Oh-Low/peeple-beeper/docs/first-boot-notes.md

# First boot notes

Work for the PCB stage. The breadboard keeps its current compass numbers and GPS schedule until then. Add the next item here when it comes up.

- [ ] Calibrate the magnetometer for the PCB.
- [ ] Calibrate true north, south, east, and west.
- [ ] Force a sky wait on first boot so the receiver can take its first satellite fix.
