Oh-Low/peeple-beeper/hardware/pcb/pcb.kicad_pcb

## KiCad design hardware/pcb/pcb.kicad_pcb (2026-11-07)

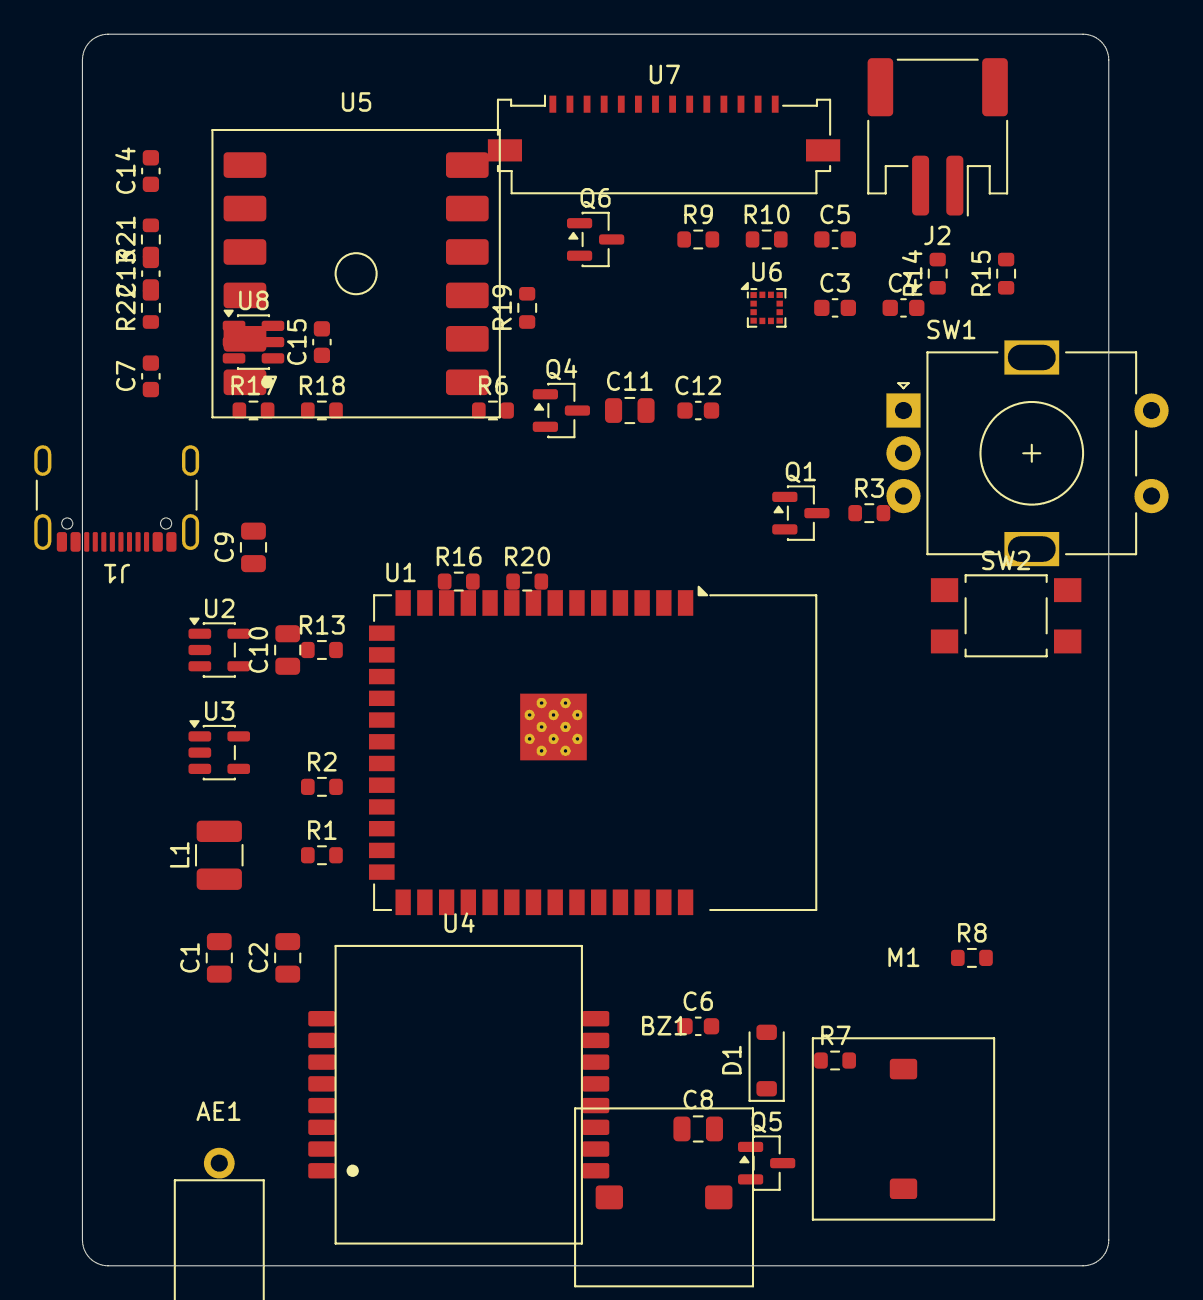
[picture p1: board pcb.kicad_pcb from above]

Board: 2 copper layers, 60.0 x 72.0 mm, 54 parts (0 on the bottom side), 44 nets, no tracks yet.

Parts:
AE1: T1-915M
BZ1: GSC1030RB-3V4000; Piezo_10x10
C1, C2, C8: 10uF; C_0805_2012Metric
C3: 220nF; C_0603_1608Metric
C4, C5, C6, C7, C12, C14, C15: 100nF; C_0603_1608Metric
C9, C10, C11: 4.7uF; C_0805_2012Metric
C13: 33pF; C_0603_1608Metric
D1: 1N4148; D_SOD-123
J1: USB4105-GF-A; USB_C_Receptacle_GCT_USB4105-xx-A_16P_TopMnt_Horizontal
J2: S2B-PH-SM4-TB; JST_PH_S2B-PH-SM4-TB_1x02-1MP_P2.00mm_Horizontal
L1: 2.2uH; L_1210_3225Metric
M1: LCM1027A2445F; Motor_Coin_10mm
Q1: BSS138; SOT-23
Q4: AO3401A; SOT-23
Q5, Q6: 2N7002; SOT-23
R1, R3, R6, R7, R14, R15, R19: 100k; R_0603_1608Metric
R2: 22.1k; R_0603_1608Metric
R8: 100; R_0603_1608Metric
R9, R10: 4.7k; R_0603_1608Metric
R13: 2.5k; R_0603_1608Metric
R16, R20: 10k; R_0603_1608Metric
R17, R18: 5.1k; R_0603_1608Metric
R21: 1k; R_0603_1608Metric
R22: 5.6k; R_0603_1608Metric
SW1: PEC11R-4220F-S0024; RotaryEncoder_Alps_EC11E-Switch_Vertical_H20mm
SW2: Back; SW_SPST_TL3305A
U1: ESP32-S3-WROOM-1-N8; ESP32-S3-WROOM-1
U2: MCP73831T-2ACI/OT; SOT-23-5
U3: TLV62568DBVT; SOT-23-5
U4: HT-RA62
U5: LC86LICMD
U6: LSM303AGRTR; LGA-12_2x2mm_P0.5mm
U7: ERC12864FSF-9; Molex_200528-0140_1x14-1MP_P1.00mm_Horizontal
U8: USBLC6-2SC6; SOT-23-6

Connections:
+3V3: C2.1, C4.1, C5.1, C6.1, C7.1, C8.1, D1.1, L1.2, M1.1, Q4.2, R1.1, R6.2, R9.2, R10.2, R16.2, U1.2, U4.3, U6.2, U6.3, U6.9, U6.10, U7.1, U7.8
BACK: SW2.1, U1.8
BAT: C1.1, C10.1, J2.1, R14.1, U2.3, U3.1, U3.4
BAT_ADC: C14.1, R14.2, R15.1, U1.4
BUCK_FB: R1.2, R2.1, U3.5
BUCK_SW: L1.1, U3.3
CC1: J1.A5, R17.1
CC2: J1.B5, R18.1
CHG_PROG: R13.1, U2.5
ENC_A: SW1.A, U1.5
ENC_B: SW1.B, U1.6
ENC_SW: SW1.S1, U1.7
ESP_EN: R16.1, U1.3
ESP_IO3: R20.1, U1.15
GND: BZ1.2, C1.2, C2.2, C3.2, C4.2, C5.2, C6.2, C7.2, C8.2, C9.2, C10.2, C11.2, C12.2, C13.2, C14.2, C15.2, J1.A1, J1.A12, J1.B1, J1.B12, J1.SH, J2.2, Q1.2, Q5.2, Q6.2, R2.2, R3.2, R7.2, R13.2, R15.2, R17.2, R18.2, R19.2, R20.2, R22.2, SW1.C, SW1.S2, SW2.2, U1.1, U1.40, U1.41, U2.2, U3.2, U4.2, U4.9, U4.16, U5.3, U5.12, U6.6, U6.8, U7.9, U8.2
GPS_EN: Q4.1, R6.1, U1.32
GPS_RST: Q6.1, R19.1, U1.33
GPS_RST_N: Q6.3, U5.10
GPS_RX: R21.2, R22.1, U5.1
GPS_RXD: R21.1, U1.31
GPS_TXD: U1.11, U5.2
GPS_VCC: C11.1, C12.1, C13.1, Q4.3, U5.4, U5.5
I2C_SCL: R10.1, U1.38, U6.1
I2C_SDA: R9.1, U1.39, U6.4
LCD_A0: U1.23, U7.5
LCD_BL: Q1.1, R3.1, U1.28
LCD_BLK: Q1.3, U7.2
LCD_CS: U1.22, U7.3
LCD_RST: U1.24, U7.4
LSM_C1: C3.1, U6.5
MOTOR: Q5.1, R7.1, U1.9
MOTOR_N: D1.2, M1.2, Q5.3
PIEZO: R8.1, U1.10
PIEZO_P: BZ1.1, R8.2
RF_ANT: AE1.1, U4.1
RF_BUSY: U1.17, U4.10
RF_CS: U1.18, U4.15
RF_RST: U1.12, U4.4
SPI_MISO: U1.21, U4.13
SPI_MOSI: U1.19, U4.14, U7.7
SPI_SCK: U1.20, U4.12, U7.6
USB_D+: J1.A6, J1.B6, U1.14, U8.1, U8.6
USB_D-: J1.A7, J1.B7, U1.13, U8.3, U8.4
VBUS: C9.1, C15.1, J1.A4, J1.A9, J1.B4, J1.B9, U2.4, U8.5
