Oh-Low/peeple-beeper/firmware/tests/screen_test.c

#include "beeper.h"
#include "emu_hal.h"
#include "util.h"

#include <stdio.h>
#include <string.h>

static int g_pass, g_fail;

#define CHECK(cond, msg)           \
  do {                             \
    if (!(cond)) {                 \
      printf("not ok  %s\n", msg); \
      g_fail++;                    \
      return;                      \
    }                              \
  } while (0)

static void pass(const char *name) {
  g_pass++;
  printf("ok  %s\n", name);
}

static void fill_page(page_t *page) {
  memset(page, 0, sizeof *page);
  str_copy_max(page->from, sizeof page->from, "Bob", sizeof page->from - 1);
  str_copy_max(page->body, sizeof page->body, "hi", sizeof page->body - 1);
}

static void test_backlight_timer(void) {
  beeper_t b;
  emu_hal_t ram;
  hal_t hal;
  page_t page;
  beeper_init(&b);
  emu_hal_init(&ram, &hal);

  b.screen.light_mode = LIGHT_30S;
  screen_light_apply(&b.screen, &hal);
  CHECK(ram.backlight_on, "30s starts lit");
  ram.now_ms = 29999;
  screen_render(&b.screen, &hal);
  CHECK(ram.backlight_on, "still lit inside 30s");
  ram.now_ms = 30000;
  screen_render(&b.screen, &hal);
  CHECK(!ram.backlight_on, "30s turns the light off");

  emu_hal_push_encoder(&ram, ENC_PRESS);
  screen_input(&b.screen, &hal);
  CHECK(ram.backlight_on, "a press turns it back on");
  ram.now_ms += 30000;
  screen_render(&b.screen, &hal);
  CHECK(!ram.backlight_on, "the new window also ends");

  fill_page(&page);
  screen_on_page(&b.screen, &hal, &page);
  CHECK(ram.backlight_on, "a page turns it back on");

  b.screen.light_mode = LIGHT_OFF;
  screen_light_apply(&b.screen, &hal);
  CHECK(!ram.backlight_on, "off stays dark");
  emu_hal_push_encoder(&ram, ENC_PRESS);
  screen_input(&b.screen, &hal);
  CHECK(!ram.backlight_on, "a press leaves off dark");

  ram.backlight_on = true;
  b.screen.light_mode = LIGHT_OFF;
  screen_light_apply(&b.screen, &hal);
  CHECK(!ram.backlight_on, "saved off drives a lit lamp down");
  screen_render(&b.screen, &hal);
  CHECK(!ram.backlight_on, "a later frame leaves off dark");

  b.screen.light_mode = LIGHT_ON;
  screen_light_apply(&b.screen, &hal);
  ram.now_ms += 400000;
  screen_render(&b.screen, &hal);
  CHECK(ram.backlight_on, "on stays lit");
  pass("backlight timer");
}

static void grab(screen_t *screen) {
  screen->mode = SCREEN_SETTINGS;
  screen->tz_edit = true;
  screen->light_edit = true;
}

static void test_settings_release(void) {
  beeper_t b;
  emu_hal_t ram;
  hal_t hal;
  page_t page;
  beeper_init(&b);
  emu_hal_init(&ram, &hal);

  grab(&b.screen);
  fill_page(&page);
  screen_on_page(&b.screen, &hal, &page);
  CHECK(!b.screen.tz_edit && !b.screen.light_edit, "a page drops a grabbed value");

  grab(&b.screen);
  b.locate.ask_n = 1;
  b.locate.ask_alert_ready = true;
  screen_poll_track(&b.screen, &hal);
  CHECK(!b.screen.tz_edit && !b.screen.light_edit, "a locate prompt drops a grabbed value");

  grab(&b.screen);
  b.locate.ask_n = 0;
  b.locate.ask_alert_ready = false;
  b.locate.tracked_note = true;
  screen_poll_track(&b.screen, &hal);
  CHECK(!b.screen.tz_edit && !b.screen.light_edit, "a tracked warning drops a grabbed value");

  b.screen.mode = SCREEN_MENU;
  b.screen.sel = 4;
  b.screen.tz_edit = true;
  b.screen.light_edit = true;
  emu_hal_push_encoder(&ram, ENC_PRESS);
  screen_input(&b.screen, &hal);
  CHECK(b.screen.mode == SCREEN_SETTINGS, "settings opens");
  CHECK(b.screen.sel == 1, "name is selected");
  CHECK(!b.screen.tz_edit && !b.screen.light_edit, "opening settings drops a grabbed value");
  pass("settings release");
}

static void test_beep_test(void) {
  beeper_t b;
  emu_hal_t ram;
  hal_t hal;
  beeper_init(&b);
  emu_hal_init(&ram, &hal);

  b.screen.mode = SCREEN_SETTINGS;
  b.screen.sel = 8;
  emu_hal_push_encoder(&ram, ENC_PRESS);
  screen_input(&b.screen, &hal);
  CHECK(b.screen.beep_test, "press arms the beep");
  screen_render(&b.screen, &hal);
  CHECK(ram.beep_ms == 65535, "settings plays the tone");
  ram.beep_ms = 0;
  screen_render(&b.screen, &hal);
  CHECK(ram.beep_ms == 65535, "settings keeps the tone armed");

  emu_hal_push_back(&ram);
  screen_input(&b.screen, &hal);
  CHECK(!b.screen.beep_test, "back clears the beep");
  CHECK(ram.beep_ms == 0, "back stops the tone");
  pass("beep test");
}

static void test_alert_keeps_chirp(void) {
  beeper_t b;
  emu_hal_t ram;
  hal_t hal;
  page_t page;
  beeper_init(&b);
  emu_hal_init(&ram, &hal);

  b.screen.mode = SCREEN_SETTINGS;
  b.screen.vibe_test = true;
  b.screen.beep_test = true;
  fill_page(&page);
  screen_on_page(&b.screen, &hal, &page);
  screen_render(&b.screen, &hal);
  CHECK(!b.screen.vibe_test && !b.screen.beep_test, "a page drops both tests");
  CHECK(ram.vibe_ms == 250 && ram.beep_ms == 80, "a page keeps its chirp");

  b.screen.mode = SCREEN_SETTINGS;
  b.screen.vibe_test = true;
  b.screen.beep_test = true;
  ram.vibe_ms = 0;
  ram.beep_ms = 0;
  b.locate.ask_n = 1;
  b.locate.ask_alert_ready = true;
  screen_poll_track(&b.screen, &hal);
  screen_render(&b.screen, &hal);
  CHECK(!b.screen.vibe_test && !b.screen.beep_test, "a locate prompt drops both tests");
  CHECK(ram.vibe_ms == 250 && ram.beep_ms == 80, "a locate prompt keeps its chirp");

  b.screen.mode = SCREEN_SETTINGS;
  b.screen.vibe_test = true;
  b.screen.beep_test = true;
  ram.vibe_ms = 250;
  ram.beep_ms = 250;
  b.radio.status = MESSAGE_DELIVERED;
  screen_poll_send(&b.screen, &hal);
  screen_render(&b.screen, &hal);
  CHECK(b.screen.mode == SCREEN_SENT, "a delivery leaves settings");
  CHECK(!b.screen.vibe_test && !b.screen.beep_test, "a delivery drops both tests");
  CHECK(ram.vibe_ms == 0 && ram.beep_ms == 0, "a delivery stops the tests");
  pass("alert keeps chirp");
}

static void test_vibe_pulse(void) {
  beeper_t b;
  emu_hal_t ram;
  hal_t hal;
  beeper_init(&b);
  emu_hal_init(&ram, &hal);

  b.screen.mode = SCREEN_SETTINGS;
  b.screen.sel = 7;
  ram.now_ms = 1000;
  emu_hal_push_encoder(&ram, ENC_PRESS);
  screen_input(&b.screen, &hal);
  screen_render(&b.screen, &hal);
  CHECK(b.screen.vibe_test, "press arms the vibe");
  CHECK(ram.vibe_ms == 250, "the pulse starts on");

  ram.now_ms = 1249;
  screen_render(&b.screen, &hal);
  CHECK(ram.vibe_ms == 1, "still on at the end of the quarter");

  ram.now_ms = 1250;
  screen_render(&b.screen, &hal);
  CHECK(ram.vibe_ms == 0, "off for the next quarter");

  ram.now_ms = 1500;
  screen_render(&b.screen, &hal);
  CHECK(ram.vibe_ms == 250, "on again after a half second");
  pass("vibe pulse");
}

int main(void) {
  test_backlight_timer();
  test_settings_release();
  test_beep_test();
  test_alert_keeps_chirp();
  test_vibe_pulse();
  printf("%d passed, %d failed\n", g_pass, g_fail);
  return g_fail ? 1 : 0;
}
