Oh-Low/peeple-beeper/(commit log)

2026-10-26 Replace the browser host with C firmware and a desktop emulator.
    Screens, paging, locate consent, and Beeple art now live in one firmware tree that the tests and the SDL emulator both run.
    [art.h, beeper.c, beeper.h, beeple.h, canned.c]
2026-10-26 Hold a second tracking ask, and share the page and locate relay.
    A locate request waits until the one on screen is answered, and a restarted Add drops the peer's old ACK when the ephemeral changes.
2026-10-27 Boot the pager on the Feather without transmitting, and keep the wire test as its own image.
    A new listen waits for a new GPS sentence, and the tests and mascot catalog sit with the code that already owned them.
2026-10-28 Power the SX1262 TCXO so the pager can transmit, and share that modem command list with the wire test.
2026-10-28 Leave the GPS on until it stores a fix, and show that fix with the compass on the wire test. Settings can turn the backlight off.
    [beeper_hal.c, board.c, board.h, bringup.c, emu_hal.c, locate.c, receiver_test.c]
2026-10-28 Center this breadboard's compass on the measured axes, and smooth the pack percent over a half-minute.
    The wire test and the pager add 275 to X and 45 to Y, then subtract 21°. The percent is a trimmed mean that moves only one way once that window is full.
2026-10-28 Hold a locate alert and an open reply long enough for a new GPS lock, and send the last stored fix if that lock misses.
    [attempt.c, attempt.h, locate.c, locate.h, locate_harness.h, locate_test.c, receiver_test.c]
2026-10-28 List the compass and first-sky work that waits for the PCB.
2026-11-01 Drive the vibrator and the piezo from the pager, and keep an alert chirp when a settings test is still armed.
    [beeper.kicad_sch]
2026-11-05 Add the compact ESP32 PCB schematic, board, and wiring docs.
    [pcb.kicad_pcb, pcb.kicad_sch]
2026-11-07 Reset the PCB schematic for a clean rewire and align the BOM with connections.
    Major modules stay on the sheet without nets or passives; the board keeps a full footprint set and module 3D envelopes. BOM discretes now match pcb-connections.
    [pcb.kicad_pcb, pcb.kicad_sch]
2026-11-07 Link each quoted PCB part to its manufacturer datasheet.
    Adds a Spec column so the BOM can be checked against the official sheets while ordering.
